matek100/iSYSTEM-labs/TouchGFX/assets/images/_ags_45f2ecca5ca648849b935e209e2a0ce7.png

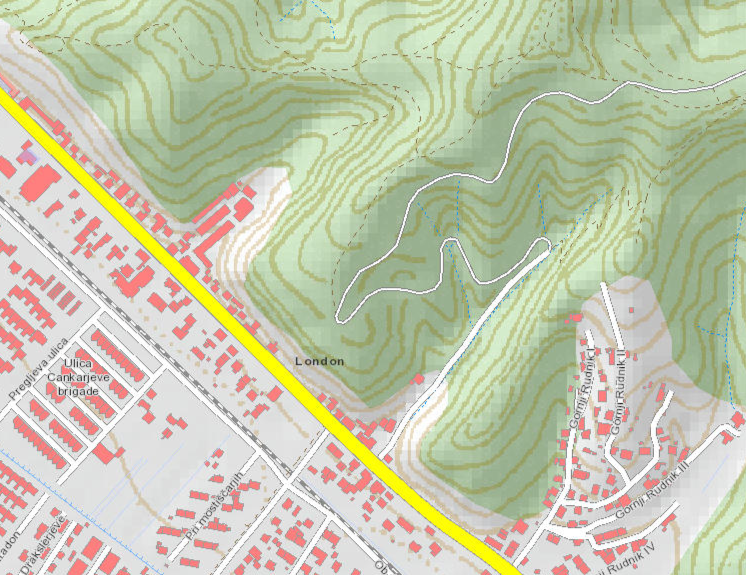
TouchGFX/assets/images/_ags_45f2ecca5ca648849b935e209e2a0ce7.png
