matek100/iSYSTEM-labs/TouchGFX/assets/images/Capture.PNG

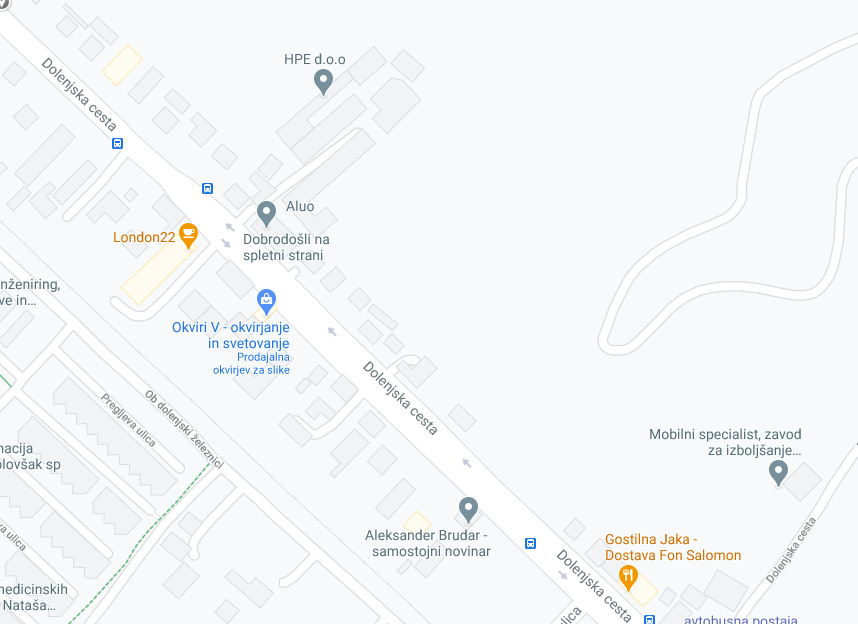
TouchGFX/assets/images/Capture.PNG
