matek100/iSYSTEM-labs/TouchGFX/assets/images/pngegg.png

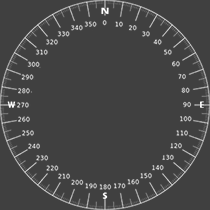
TouchGFX/assets/images/pngegg.png
