matek100/iSYSTEM-labs/TouchGFX/assets/images/pngegg_1.png

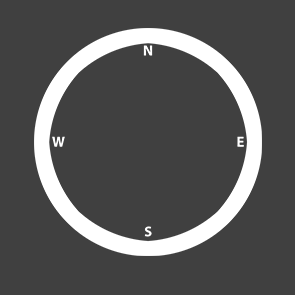
TouchGFX/assets/images/pngegg_1.png
