matek100/iSYSTEM-labs/TouchGFX/assets/images/pngegg_1_.png

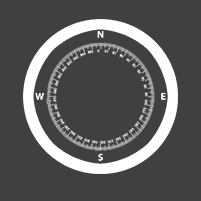
TouchGFX/assets/images/pngegg_1_.png
