matek100/iSYSTEM-labs/(list of files, drawings)

Other design files:
iSystem board/iSystem-arduino_connector.SchDoc
iSystem board/iSystem-battery_charger.SchDoc
iSystem board/iSystem-boards.SchDoc
iSystem board/iSystem-FDCAN.SchDoc
iSystem board/iSystem-jumpers.SchDoc
iSystem board/iSystem-Mechanical.SchDoc
iSystem board/iSystem-ST_MOD.SchDoc
iSystem board/iSystem.PrjPcb
iSystem board/iSystem.SchDoc
