matek100/iSYSTEM-labs/STM32H750B-DK.ioc

Mcu.UserName=STM32H750XBHx
PA11.Signal=USB_OTG_FS_DM
PA12.Signal=USB_OTG_FS_DP
PA2.GPIO_Label=LCD_RESET
PA2.Signal=GPIO_Output
PA6.Signal=GPIO_Output
PB10.Signal=USART3_TX
PB11.Signal=USART3_RX
PB6.Signal=USART1_TX
PB7.Signal=USART1_RX
PC0.Signal=ADCx_INP10
PD0.Signal=FMC_D2_DA2
PD1.Signal=FMC_D3_DA3
PD10.Signal=FMC_D15_DA15
PD11.Signal=QUADSPI_BK1_IO0
PD14.Signal=FMC_D0_DA0
PD15.Signal=FMC_D1_DA1
PD5.Signal=USART2_TX
PD6.Signal=USART2_RX
PD7.GPIO_Label=LCD_DE
PD7.Signal=GPIO_Output
PD8.Signal=FMC_D13_DA13
PD9.Signal=FMC_D14_DA14
PE0.Signal=FMC_NBL0
PE1.Signal=FMC_NBL1
PE10.Signal=FMC_D7_DA7
PE11.Signal=FMC_D8_DA8
PE12.Signal=FMC_D9_DA9
PE13.Signal=FMC_D10_DA10
PE14.Signal=FMC_D11_DA11
PE15.Signal=FMC_D12_DA12
PE3.GPIO_Label=BUZZER
PE3.Signal=GPIO_Output
PE7.Signal=FMC_D4_DA4
PE8.Signal=FMC_D5_DA5
PE9.Signal=FMC_D6_DA6
PF0.Signal=FMC_A0
PF1.Signal=FMC_A1
PF10.Signal=QUADSPI_CLK
PF11.Signal=FMC_SDNRAS
PF12.Signal=FMC_A6
PF13.Signal=FMC_A7
PF14.Signal=FMC_A8
PF15.Signal=FMC_A9
PF2.Signal=FMC_A2
PF3.Signal=FMC_A3
PF4.Signal=FMC_A4
PF5.Signal=FMC_A5
PF6.Signal=QUADSPI_BK1_IO3
PF7.Signal=QUADSPI_BK1_IO2
PF8.Signal=ADC3_INP7
PF9.Signal=QUADSPI_BK1_IO1
PG0.Signal=FMC_A10
PG1.Signal=FMC_A11
PG14.Signal=QUADSPI_BK2_IO3
PG15.Signal=FMC_SDNCAS
PG3.Signal=GPIO_Output
PG4.Signal=FMC_A14_BA0
PG5.Signal=FMC_A15_BA1
PG6.Signal=QUADSPI_BK1_NCS
PG8.Signal=FMC_SDCLK
PG9.Signal=QUADSPI_BK2_IO2
PH2.Signal=QUADSPI_BK2_IO0
PH3.Signal=QUADSPI_BK2_IO1
PH5.Signal=FMC_SDNWE
PH6.Signal=FMC_SDNE1
PH7.Signal=FMC_SDCKE1
PH9.Signal=LTDC_R3
PI0.Signal=LTDC_G5
PI1.Signal=LTDC_G6
PI12.Signal=LTDC_HSYNC
PI13.GPIO_Label=RENDER_TIME
PI13.Signal=GPIO_Output
PI14.Signal=LTDC_CLK
PI15.Signal=LTDC_R0
PI9.Signal=LTDC_VSYNC
PJ0.Signal=LTDC_R1
PJ1.Signal=LTDC_R2
PJ10.Signal=LTDC_G3
PJ11.Signal=LTDC_G4
PJ12.Signal=LTDC_B0
PJ13.Signal=LTDC_B1
PJ14.Signal=LTDC_B2
PJ15.Signal=LTDC_B3
PJ2.GPIO_Label=VSYNC_FREQ
PJ2.Signal=GPIO_Output
PJ3.Signal=LTDC_R4
PJ4.Signal=LTDC_R5
PJ5.Signal=LTDC_R6
PJ6.Signal=LTDC_R7
PJ7.Signal=LTDC_G0
PJ8.Signal=LTDC_G1
PJ9.Signal=LTDC_G2
PK0.GPIO_Label=LCD_BL_CTRL
PK0.Signal=GPIO_Output
PK1.Signal=GPIO_Input
PK2.Signal=LTDC_G7
PK3.Signal=LTDC_B4
PK4.Signal=LTDC_B5
PK5.Signal=LTDC_B6
PK6.Signal=LTDC_B7
PK7.Signal=LTDC_DE
