matek100/iSYSTEM-labs/Core/Inc/main.h

#define LCD_DE_Pin GPIO_PIN_7
#define LCD_DE_GPIO_Port GPIOD
#define BUZZER_Pin GPIO_PIN_3
#define BUZZER_GPIO_Port GPIOE
#define RENDER_TIME_Pin GPIO_PIN_13
#define RENDER_TIME_GPIO_Port GPIOI
#define LCD_BL_CTRL_Pin GPIO_PIN_0
#define LCD_BL_CTRL_GPIO_Port GPIOK
#define LCD_RESET_Pin GPIO_PIN_2
#define LCD_RESET_GPIO_Port GPIOA
#define VSYNC_FREQ_Pin GPIO_PIN_2
#define VSYNC_FREQ_GPIO_Port GPIOJ
