matek100/iSYSTEM-labs/STM32CubeIDE/Application/User/externs.h

/*
 * externs.h
 *
 *  Created on: 19 Feb 2021
 *      Author: domen
 */

#ifndef APPLICATION_USER_EXTERNS_H_
#define APPLICATION_USER_EXTERNS_H_

extern char OUTPUT[201];



#endif /* APPLICATION_USER_EXTERNS_H_ */
